3DFabrik/Rotor_Remote_V1_TFT/Pictures/CDE_controler_refurbish (1).JPG

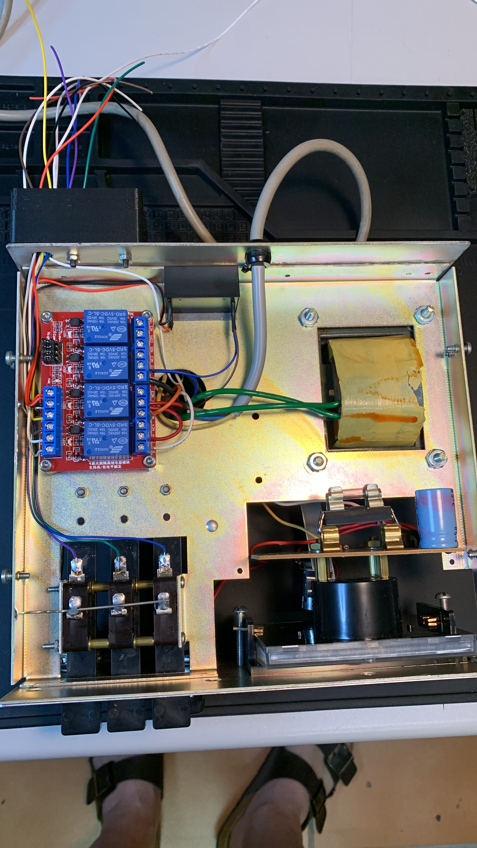
Pictures/CDE_controler_refurbish (1).JPG
