3DFabrik/Rotor_Remote_V1_TFT/Pictures/CDE_controler_refurbish (5).JPG

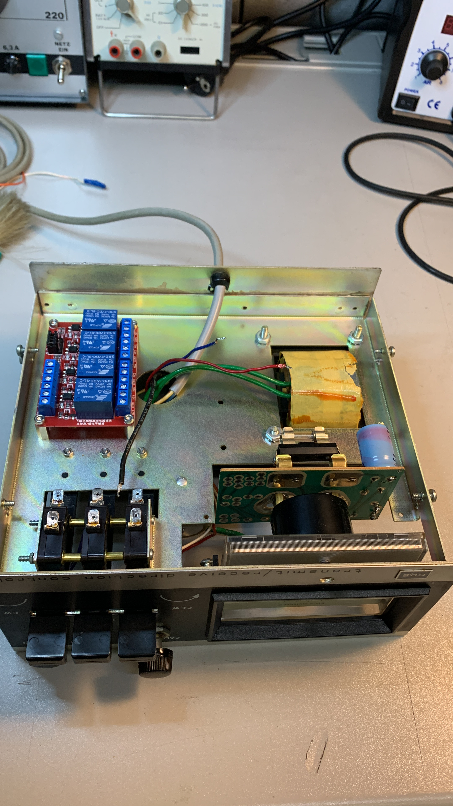
Pictures/CDE_controler_refurbish (5).JPG
