3DFabrik/Rotor_Remote_V1_TFT/Pictures/Innen 1.png

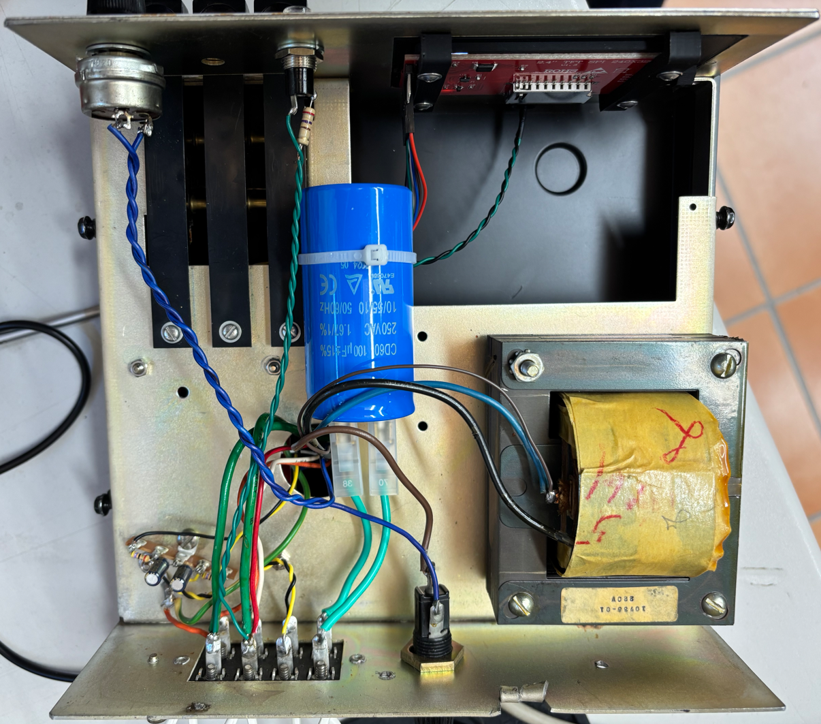
Pictures/Innen 1.png
