3DFabrik/Rotor_Remote_V1_TFT/Pictures/Pot supply filter (2).JPG

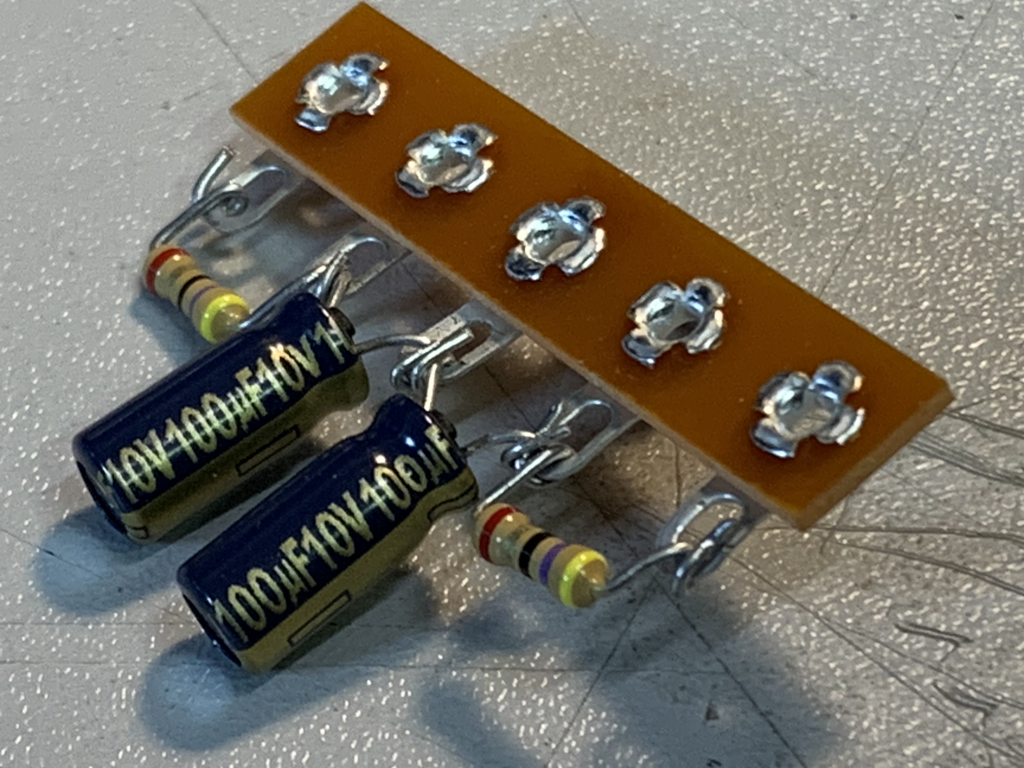
Pictures/Pot supply filter (2).JPG
