3DFabrik/Rotor_Remote_V1_TFT/Pictures/Pot supply filter (4).JPG

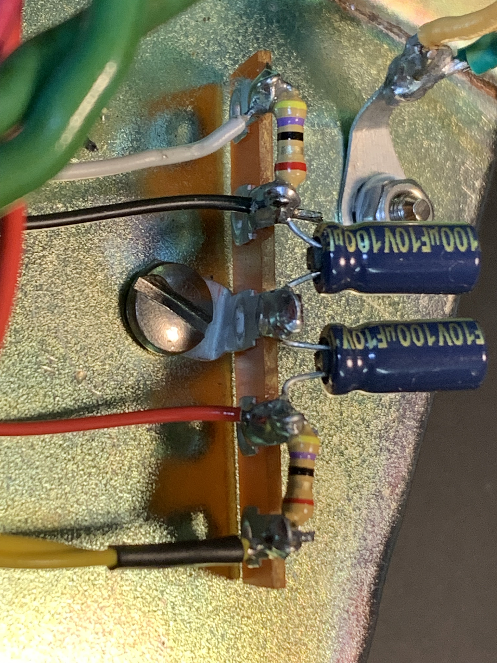
Pictures/Pot supply filter (4).JPG
