3DFabrik/Rotor_Remote_V1_TFT/RotorWifi.ino

WiFiServer rotServer;
WiFiClient rotClient;
bool rotServerStarted = false;
WebServer httpOta(80);
static bool otaReady = false;
static bool otaBusy = false;
static bool otaWeb = false;
static bool otaBeginOk = false;
static bool otaOk = false;
static bool otaUploadStarted = false;
unsigned long otaWifiLostAt = 0;
static String otaErr;
static void otaQuiesceNetwork();

static int wifiScanState = 0;  // 0 idle, 1 running, 2 done
static int wifiScanN = 0;
static bool wifiScanDirty = false;

static char rotLine[96];
static int rotLineLen = 0;

static const int WEB_LOG_N = 16;
static const int WEB_LOG_W = 96;
static char webLogLines[WEB_LOG_N][WEB_LOG_W];
static uint8_t webLogHead = 0;
static uint8_t webLogCount = 0;
static bool ntpStarted = false;

int webJog = 0;
unsigned long webJogAt = 0;
static uint32_t statusHits = 0;
static uint32_t jogHits = 0;

void webLog(const char *src, const char *msg) {
  if (!src) src = "";
  if (!msg) msg = "";
  char stamp[24] = "--";
  time_t now = time(nullptr);
  if (now > 1700000000) {
    struct tm tmNow;
    localtime_r(&now, &tmNow);
    strftime(stamp, sizeof(stamp), "%d.%m.%Y %H:%M:%S", &tmNow);
  }
  char *d = webLogLines[webLogHead];
  snprintf(d, WEB_LOG_W, "%s %s %s", stamp, src, msg);
  NETLOG("log %s", d);
  webLogHead = (webLogHead + 1) % WEB_LOG_N;
  if (webLogCount < WEB_LOG_N) webLogCount++;
}

static void webJogExpire() {
  if (webJog != 0 && (millis() - webJogAt > 500)) {
    webJog = 0;
    webLog("web", "stop");
  }
}

bool linkWantsBt() {
  return linkMode == LINK_BT;
}

bool linkWantsWifi() {
  return linkMode == LINK_WIFI;
}

const char *wifiStateLabel() {
  if (!wifiWanted && !linkWantsWifi()) return "off";
  switch (WiFi.status()) {
    case WL_CONNECTED: return "connected";
    case WL_NO_SSID_AVAIL: return "no SSID";
    case WL_CONNECT_FAILED: return "failed";
    case WL_CONNECTION_LOST: return "lost";
    case WL_DISCONNECTED: return "offline";
    default: return wifiSsid.length() ? "connecting..." : "no SSID";
  }
}

String wifiIpCurrent() {
  if (linkWantsWifi() && WiFi.status() == WL_CONNECTED) return WiFi.localIP().toString();
  return ipMode ? ipLocal : String("-");
}

int wifiRssiBars() {
  if (WiFi.status() != WL_CONNECTED) return 0;
  int r = WiFi.RSSI();
  if (r >= -55) return 3;
  if (r >= -70) return 2;
  if (r >= -85) return 1;
  return 0;
}

static void otaShowScreen(const char *msg, const char *sub = nullptr) {
  tft.fillScreen(TFT_BLACK);
  tft.setTextDatum(MC_DATUM);
  tft.setTextColor(TFT_YELLOW, TFT_BLACK);
  tft.drawString(msg, 160, 120, 4);
  if (sub) {
    tft.setTextColor(TFT_WHITE, TFT_BLACK);
    tft.drawString(sub, 160, 160, 2);
  }
  tft.setTextDatum(TL_DATUM);
}

static int otaPct = -1;

static void otaDrawProgress(unsigned long done, unsigned long total) {
  if (!total) return;
  int pct = (int)(done * 100UL / total);
  if (pct > 100) pct = 100;
  if (pct == otaPct) return;
  otaPct = pct;
  tft.drawRoundRect(40, 150, 240, 16, 3, TFT_WHITE);
  tft.fillRect(42, 152, (236 * pct) / 100, 12, TFT_GREEN);
  tft.setTextDatum(MC_DATUM);
  tft.setTextColor(TFT_WHITE, TFT_BLACK);
  tft.setTextPadding(80);
  tft.drawString(String(pct) + "%", 160, 190, 4);
  tft.setTextPadding(0);
  tft.setTextDatum(TL_DATUM);
}

static void otaGiveUp(const char *msg) {
  static bool once = false;
  if (once) return;
  once = true;
  Update.abort();
  otaShowScreen(msg);
  delay(1200);
  ESP.restart();
}

static void otaFailScreen(const String &err) {
  otaShowScreen("Update failed");
  tft.setTextDatum(MC_DATUM);
  tft.setTextColor(TFT_WHITE, TFT_BLACK);
  tft.drawString(err, 160, 170, 2);
  tft.setTextDatum(TL_DATUM);
}

bool otaIsBusy() {
  return otaBusy;
}

#define PAGE_CSS \
  "body{font-family:sans-serif;background:#111;color:#eee;margin:0}" \
  "header{background:#1a2332;padding:16px 20px;border-bottom:1px solid #345}" \
  "header h1{margin:0;font-size:22px;color:#6cf}" \
  ".ver{color:#9ab;margin-top:6px;font-size:14px}" \
  "nav{margin-top:14px}" \
  "nav a{color:#9ab;margin-right:18px;text-decoration:none}" \
  "nav a.on{color:#6cf;font-weight:bold}" \
  "main{padding:24px;max-width:640px}" \
  "p{line-height:1.45}" \
  ".note{color:#9ab}" \
  ".top{display:flex;gap:16px;align-items:center;flex-wrap:wrap;margin:12px 0}" \
  ".cards{display:flex;flex-direction:column;gap:12px;flex:1;min-width:150px}" \
  ".top svg{flex:none;width:200px;height:200px}" \
  ".card{background:#1a2332;border:1px solid #345;border-radius:8px;padding:14px}" \
  ".card h2{margin:0 0 8px;font-size:13px;color:#9ab;font-weight:normal}" \
  ".big{font-size:28px;color:#6cf}" \
  ".badge{display:inline-block;padding:2px 10px;border-radius:10px;background:#333;color:#9ab;font-size:12px}" \
  ".badge.on{background:#1a6;color:#fff}" \
  "select.log{width:100%;height:220px;background:#0d1117;color:#c9d1d9;border:1px solid #345;" \
  "font-family:ui-monospace,monospace;font-size:13px;padding:4px}" \
  ".jog{display:flex;gap:8px;align-items:center;flex-wrap:wrap;margin:8px 0 18px}" \
  ".jog button{font-size:15px;padding:10px 16px;background:#246;color:#fff;border:0;border-radius:8px;touch-action:none;" \
  "user-select:none;-webkit-user-select:none;-webkit-touch-callout:none;-webkit-tap-highlight-color:transparent}" \
  ".jog button:active{background:#3a7}" \
  ".jog input:not([type=checkbox]){width:84px;font-size:16px;padding:9px;background:#0d1117;color:#eee;border:1px solid #345;border-radius:6px}" \
  ".jog #tcall{width:150px;text-transform:uppercase}.jog label{color:#9ab;font-size:14px}" \
  ".tx{background:#0d1117;color:#eee;border:1px solid #345;border-radius:6px;padding:9px;font-size:16px}" \
  ".wide{width:100%;max-width:420px;box-sizing:border-box}" \
  ".btn{font-size:15px;padding:10px 16px;background:#246;color:#fff;border:0;border-radius:8px}" \
  ".jog #go{background:#2a7}.jog #stp{background:#a33}" \
  "input[type=file]{display:block;margin:16px 0}" \
  "input[type=submit]{font-size:16px;padding:10px 18px;background:#246;color:#fff;border:0;border-radius:6px}"

#define PAGE_HEAD(NAV) \
  "<!DOCTYPE html><html><head><meta charset='utf-8'>" \
  "<meta name='viewport' content='width=device-width,initial-scale=1'>" \
  "<title>RotorRemote</title><style>" PAGE_CSS "</style></head><body>" \
  "<header><h1>RotorRemote</h1><div class='ver'>Firmware <span id='ver'>-</span></div>" \
  "<nav>" NAV "</nav></header><main>"

// Served from flash so no heap is needed to build the page.
static const char HOME_PAGE[] PROGMEM =
  PAGE_HEAD("<a class='on' href='/'>Home</a><a href='/wavelog'>Wavelog</a><a href='/update'>Update</a>")
  "<p>rotctld: <span id='addr'>-</span> <span id='badge' class='badge'>no client</span></p>"
  "<div class='top'><div class='cards'>"
  "<div class='card'><h2>Azimuth</h2><div class='big' id='az'>-</div></div>"
  "<div class='card'><h2>Motion</h2><div class='big' id='dir'>-</div></div></div>"
  "<svg viewBox='0 0 200 200'>"
  "<circle cx='100' cy='100' r='84' fill='#0d1117' stroke='#345' stroke-width='2'/><g id='ticks'></g>"
  "<g fill='#6cf' font-size='14' text-anchor='middle'><text x='100' y='52'>N</text><text x='100' y='158'>S</text>"
  "<text x='166' y='106'>E</text><text x='34' y='106'>W</text></g>"
  "<g id='tg' visibility='hidden'><polygon points='100,15 93,2 107,2' fill='#fc3'/></g>"
  "<g id='ndl'><rect x='97' y='50' width='6' height='50' fill='#e33'/><polygon points='100,24 87,52 113,52' fill='#e33'/></g>"
  "<circle cx='100' cy='100' r='5' fill='#9ab'/></svg></div>"
  "<p class='note'>Target <span id='tgt'>-</span> &nbsp; Debug <span id='dbg'>-</span> &nbsp; Heap <span id='hp'>-</span></p>"
  "<div class='jog'><button id='ccw' type='button'>CCW</button><button id='cw' type='button'>CW</button>"
  "<input id='gaz' type='number' inputmode='numeric' min='0' max='359' placeholder='0-359'>"
  "<button id='go' type='button'>GO</button><button id='stp' type='button'>STOP</button>"
  "<span id='gmsg' class='note'></span></div>"
  "<div class='jog'><input id='tcall' type='text' autocapitalize='characters' autocomplete='off' spellcheck='false' placeholder='Call or locator'>"
  "<button id='fnd' type='button'>FIND</button><label><input id='lp' type='checkbox'> long path</label>"
  "<span id='tinfo' class='note'></span></div>"
  "<h2>rotctld / debug</h2>"
  "<select class='log' id='log' size='12'></select>"
  "<script>"
  "for(let i=0;i<36;i++){const l=document.createElementNS('http://www.w3.org/2000/svg','line');"
  "l.setAttribute('x1',100);l.setAttribute('y1',16);l.setAttribute('x2',100);l.setAttribute('y2',16+(i%9==0?14:i%3==0?9:5));"
  "l.setAttribute('stroke','#9ab');l.setAttribute('transform','rotate('+i*10+' 100 100)');ticks.appendChild(l);}"
  "async function tick(){try{const r=await fetch('/status',{cache:'no-store'});if(r.ok){const s=await r.json();"
  "az.textContent=Number(s.az).toFixed(1)+'\\u00b0';"
  "dir.textContent=s.dir;dir.style.color=s.turning?'#6f6':'#9ab';"
  "tgt.textContent=s.target+'\\u00b0';dbg.textContent=s.debug?'on':'off';"
  "badge.textContent=s.client?'client connected':'no client';badge.className=s.client?'badge on':'badge';"
  "ndl.setAttribute('transform','rotate('+s.az+' 100 100)');"
  "if(s.auto){tg.setAttribute('visibility','visible');tg.setAttribute('transform','rotate('+s.target+' 100 100)');}"
  "else tg.setAttribute('visibility','hidden');"
  "ver.textContent=s.ver;addr.textContent=s.ip+':'+s.port;hp.textContent=s.heap;"
  "const el=log;el.innerHTML='';"
  "(s.log||[]).forEach(t=>el.add(new Option(t)));"
  "if(el.options.length)el.selectedIndex=el.options.length-1;"
  "}}catch(e){}setTimeout(tick,800);}tick();"
  "function bindJog(id,dir){const el=document.getElementById(id);let on=false,t=null;"
  "const H={'Content-Type':'application/x-www-form-urlencoded'};"
  "const stop=()=>{if(!on)return;on=false;clearInterval(t);fetch('/jog',{method:'POST',headers:H,body:'dir=stop'}).catch(()=>{});};"
  "const send=b=>fetch('/jog',{method:'POST',headers:H,body:b}).then(r=>{if(r.status==409&&on){on=false;clearInterval(t);}}).catch(()=>{});"
  "el.addEventListener('pointerdown',e=>{e.preventDefault();if(on)return;el.setPointerCapture(e.pointerId);on=true;"
  "send('dir='+dir+'&start=1');t=setInterval(()=>send('dir='+dir),200);});"
  "['pointerup','pointercancel','lostpointercapture','touchend','touchcancel','contextmenu','selectstart'].forEach(n=>"
  "el.addEventListener(n,e=>{if(n=='contextmenu'||n=='selectstart')e.preventDefault();stop();}));"
  "window.addEventListener('blur',stop);window.addEventListener('pagehide',stop);"
  "document.addEventListener('visibilitychange',stop);}"
  "bindJog('ccw','ccw');bindJog('cw','cw');"
  "const hdr={'Content-Type':'application/x-www-form-urlencoded'};"
  "const say=m=>{gmsg.textContent=m;setTimeout(()=>{gmsg.textContent='';},2500);};"
  "const send2=b=>fetch('/go',{method:'POST',headers:hdr,body:b}).then(r=>say(r.ok?'ok':r.status==409?'busy':'rejected')).catch(()=>say('no answer'));"
  "go.onclick=()=>{const v=gaz.value.trim();if(!/^\\d{1,3}$/.test(v)||+v>359){say('0-359');gaz.focus();return;}send2('az='+v);};"
  "stp.onclick=()=>send2('stop=1');"
  "gaz.addEventListener('keydown',e=>{if(e.key=='Enter')go.click();});"
  "const LOC=/^[A-R]{2}\\d\\d([A-X]{2}(\\d\\d)?)?$/i;"
  "function l2ll(g){g=g.toUpperCase();let lon=(g.charCodeAt(0)-65)*20-180,lat=(g.charCodeAt(1)-65)*10-90,w=2,h=1;"
  "lon+=+g[2]*2;lat+=+g[3];"
  "if(g.length>=6){w=2/24;h=1/24;lon+=(g.charCodeAt(4)-65)*w;lat+=(g.charCodeAt(5)-65)*h;"
  "if(g.length==8){w/=10;h/=10;lon+=+g[6]*w;lat+=+g[7]*h;}}"
  "return[lat+h/2,lon+w/2];}"
  "function brg(a,b){const r=Math.PI/180,f1=a[0]*r,f2=b[0]*r,dl=(b[1]-a[1])*r;"
  "return(Math.atan2(Math.sin(dl)*Math.cos(f2),Math.cos(f1)*Math.sin(f2)-Math.sin(f1)*Math.cos(f2)*Math.cos(dl))/r+360)%360;}"
  "function dst(a,b){const r=Math.PI/180,dp=(b[0]-a[0])*r,dl=(b[1]-a[1])*r;"
  "const h=Math.sin(dp/2)**2+Math.cos(a[0]*r)*Math.cos(b[0]*r)*Math.sin(dl/2)**2;return 12742*Math.asin(Math.sqrt(h));}"
  "function wb(u){return u.replace(/\\/+$/,'').replace(/\\/api\\/v2$/,'').replace(/\\/index\\.php$/,'')+'/index.php/api/v2';}"
  "async function wl(S,path){const r=await fetch(wb(S.url)+'/'+path,{headers:{'Authorization':'Bearer '+S.key}});"
  "if(!r.ok){let m='Wavelog answered '+r.status;try{const e=await r.json();if(e.error)m=e.error.message||e.error.code;}catch(_){}throw new Error(m);}"
  "return(await r.json()).data;}"
  "fnd.onclick=async()=>{try{tinfo.textContent='...';"
  "const S=await(await fetch('/wl.json',{cache:'no-store'})).json();"
  "const q=tcall.value.trim().toUpperCase();if(!q)throw new Error('Enter a call or locator');"
  "let ll,lab=q,approx=false;"
  "if(LOC.test(q)){ll=l2ll(q);}else{"
  "if(!S.url||!S.key)throw new Error('Set URL and token on the Wavelog tab');"
  "const j=await wl(S,'lookup?callsign='+encodeURIComponent(q)+'&detail=full&callbook=true');"
  "const cb=j.callbook||{};const g=[j.gridsquare,cb.gridsquare,cb.grid,cb.locator].find(x=>x&&LOC.test(x));"
  "if(g){ll=l2ll(g);lab=q+' '+g;}"
  "else if(isFinite(parseFloat(j.dxcc_lat))&&isFinite(parseFloat(j.dxcc_long))){ll=[+j.dxcc_lat,+j.dxcc_long];approx=true;}"
  "else throw new Error('No location for '+q);}"
  "let me=S.loc;if(!me){if(!S.url||!S.key)throw new Error('Own locator missing');"
  "const st=await wl(S,'station');const a=st.find(x=>x.active)||st[0];me=a&&a.gridsquare;}"
  "if(!me||!LOC.test(me))throw new Error('Own locator unknown');"
  "const own=l2ll(me);let b=brg(own,ll),d=dst(own,ll);"
  "if(lp.checked){b=(b+180)%360;d=40030-d;}"
  "const az=Math.round(b)%360;gaz.value=az;"
  "tinfo.textContent=lab+(approx?' (country centre)':'')+': '+az+'\\u00b0, '+Math.round(d)+' km'+(lp.checked?' long path':'')+'. Press GO.';"
  "}catch(e){tinfo.textContent=(e instanceof TypeError)?'No answer from Wavelog (URL or CORS)':e.message;}};"
  "tcall.addEventListener('keydown',e=>{if(e.key=='Enter')fnd.click();});"
  "</script></main></body></html>";

static const char UPDATE_PAGE[] PROGMEM =
  PAGE_HEAD("<a href='/'>Home</a><a href='/wavelog'>Wavelog</a><a class='on' href='/update'>Update</a>")
  "<h2>Firmware update</h2>"
  "<p>Use <strong>RotorRemote_ota.bin</strong> (app image). Do not upload the USB merged <strong>RotorRemote.bin</strong>.</p>"
  "<form method='POST' action='/update' enctype='multipart/form-data'>"
  "<input type='file' name='firmware' accept='.bin'>"
  "<input type='submit' value='Flash'></form>"
  "<p class='note'>Leave the home page before flashing: it polls the controller. "
  "The display switches to Updating when the file transfer starts. "
  "The controller restarts after a successful update.</p>"
  "<script>fetch('/status').then(r=>r.json()).then(s=>{document.getElementById('ver').textContent=s.ver}).catch(()=>{});</script>"
  "</main></body></html>";

static const char WAVELOG_PAGE[] PROGMEM =
  PAGE_HEAD("<a href='/'>Home</a><a class='on' href='/wavelog'>Wavelog</a><a href='/update'>Update</a>")
  "<h2>Wavelog</h2>"
  "<p class='note'>Used on the Home page to find a callsign and turn the rotor towards it. "
  "In Wavelog create an <strong>API v2 token</strong> (user menu, API) with the scopes <strong>lookup:read</strong> and "
  "<strong>station:read</strong>. The token is stored in this controller and is visible to anyone who can open this page.</p>"
  "<p>URL<br><input id='wu' class='tx wide' type='text' placeholder='https://log.example.com' autocomplete='off'></p>"
  "<p>API v2 token (wl2_...)<br><input id='wk' class='tx wide' type='password' autocomplete='off'></p>"
  "<p>Own locator (empty = taken from the active Wavelog station)<br>"
  "<input id='wloc' class='tx' type='text' maxlength='8' placeholder='JO30oo' autocomplete='off'></p>"
  "<p><button id='sv' class='btn' type='button'>Save</button> <button id='ts' class='btn' type='button'>Test</button> "
  "<span id='wm' class='note'></span></p>"
  "<script>"
  "fetch('/status').then(r=>r.json()).then(s=>{ver.textContent=s.ver}).catch(()=>{});"
  "fetch('/wl.json',{cache:'no-store'}).then(r=>r.json()).then(s=>{wu.value=s.url;wk.value=s.key;wloc.value=s.loc;}).catch(()=>{});"
  "sv.onclick=async()=>{try{const b='url='+encodeURIComponent(wu.value.trim())+'&key='+encodeURIComponent(wk.value.trim())"
  "+'&loc='+encodeURIComponent(wloc.value.trim());"
  "const r=await fetch('/wl',{method:'POST',headers:{'Content-Type':'application/x-www-form-urlencoded'},body:b});"
  "wm.textContent=r.ok?'saved':'rejected: check the characters in URL, key and locator';}catch(e){wm.textContent='no answer';}};"
  "function wb(u){return u.replace(/\\/+$/,'').replace(/\\/api\\/v2$/,'').replace(/\\/index\\.php$/,'')+'/index.php/api/v2';}"
  "async function wl(S,path){const r=await fetch(wb(S.url)+'/'+path,{headers:{'Authorization':'Bearer '+S.key}});"
  "if(!r.ok){let m='Wavelog answered '+r.status;try{const e=await r.json();if(e.error)m=e.error.message||e.error.code;}catch(_){}throw new Error(m);}"
  "return(await r.json()).data;}"
  "ts.onclick=async()=>{try{wm.textContent='...';const S={url:wu.value.trim(),key:wk.value.trim()},out=[];"
  "await wl(S,'token');out.push('token ok');"
  "try{const st=await wl(S,'station');const a=st.find(x=>x.active)||st[0];out.push('station '+(a?a.gridsquare:'none'));}"
  "catch(e){out.push('station: '+e.message);}"
  "try{await wl(S,'lookup?callsign=DL1ABC&detail=basic');out.push('lookup ok');}catch(e){out.push('lookup: '+e.message);}"
  "wm.textContent=out.join(', ');}"
  "catch(e){wm.textContent='failed: '+e.message+(e instanceof TypeError?' (URL or network)':'');}};"
  "</script></main></body></html>";

static char statusJson[3072];

static bool wlPlain(const String &s, size_t maxLen, const char *extra) {
  if (s.length() > maxLen) return false;
  for (size_t i = 0; i < s.length(); i++) {
    char c = s.charAt(i);
    if (!isalnum((unsigned char)c) && !strchr(extra, c)) return false;
  }
  return true;
}

static size_t statusAdd(size_t n, const char *s) {
  while (*s && n + 1 < sizeof(statusJson)) statusJson[n++] = *s++;
  statusJson[n] = 0;
  return n;
}

static size_t statusAddEsc(size_t n, const char *s) {
  while (*s && n + 2 < sizeof(statusJson)) {
    unsigned char c = (unsigned char)*s++;
    if (c < 32) continue;
    if (c == '"' || c == '\\') statusJson[n++] = '\\';
    statusJson[n++] = (char)c;
  }
  statusJson[n] = 0;
  return n;
}

static size_t buildStatusJson() {
  const char *dir = "Stopped";
  bool ccw = digitalRead(pin_out_CCW_relais);
  bool cw = digitalRead(pin_out_CW_relais);
  if (ccw) dir = "Turning CCW";
  else if (cw) dir = "Turning CW";
  int compassTarget = azimut_tar + 180;
  if (compassTarget >= 360) compassTarget -= 360;
  char num[16];
  size_t n = 0;
  statusJson[0] = 0;
  n = statusAdd(n, "{\"az\":");
  snprintf(num, sizeof(num), "%.1f", (double)azimut);
  n = statusAdd(n, num);
  n = statusAdd(n, ",\"target\":");
  snprintf(num, sizeof(num), "%d", compassTarget);
  n = statusAdd(n, num);
  n = statusAdd(n, ",\"turning\":");
  n = statusAdd(n, (ccw || cw) ? "true" : "false");
  n = statusAdd(n, ",\"auto\":");
  n = statusAdd(n, b_autorotate ? "true" : "false");
  n = statusAdd(n, ",\"speed\":");
  snprintf(num, sizeof(num), "%.1f", (double)v_turn);
  n = statusAdd(n, num);
  n = statusAdd(n, ",\"dir\":\"");
  n = statusAdd(n, dir);
  n = statusAdd(n, "\",\"debug\":");
  n = statusAdd(n, debug ? "true" : "false");
  n = statusAdd(n, ",\"client\":");
  n = statusAdd(n, (rotClient && rotClient.connected()) ? "true" : "false");
  n = statusAdd(n, ",\"heap\":");
  snprintf(num, sizeof(num), "%u", (unsigned)ESP.getFreeHeap());
  n = statusAdd(n, num);
  n = statusAdd(n, ",\"maxblk\":");
  snprintf(num, sizeof(num), "%u", (unsigned)ESP.getMaxAllocHeap());
  n = statusAdd(n, num);
  n = statusAdd(n, ",\"ver\":\"" FW_VERSION "\",\"ip\":\"");
  n = statusAdd(n, WiFi.localIP().toString().c_str());
  n = statusAdd(n, "\",\"port\":");
  snprintf(num, sizeof(num), "%d", rotPort);
  n = statusAdd(n, num);
  n = statusAdd(n, ",\"log\":[");
  int start = (webLogHead + WEB_LOG_N - webLogCount) % WEB_LOG_N;
  for (int i = 0; i < webLogCount; i++) {
    if (i) n = statusAdd(n, ",");
    n = statusAdd(n, "\"");
    n = statusAddEsc(n, webLogLines[(start + i) % WEB_LOG_N]);
    n = statusAdd(n, "\"");
  }
  n = statusAdd(n, "]}");
  return n;
}

static void otaStop() {
  if (!otaReady) return;
  httpOta.stop();
  ArduinoOTA.end();
  otaReady = false;
}

static void otaBegin() {
  if (otaReady) return;

  ArduinoOTA.setHostname(btName.length() ? btName.c_str() : "RotorRemote");
  ArduinoOTA.onStart([]() {
    otaQuiesceNetwork();
    otaPct = -1;
    otaShowScreen("Updating...");
  });
  ArduinoOTA.onProgress([](unsigned int done, unsigned int total) {
    otaDrawProgress(done, total);
  });
  ArduinoOTA.onEnd([]() {
    otaShowScreen("Update OK", "Restarting...");
  });
  ArduinoOTA.onError([](ota_error_t err) {
    (void)err;
    otaGiveUp("Update failed");
  });
  ArduinoOTA.begin();

  httpOta.on("/", HTTP_GET, []() {
    NETLOG("http / from %s", httpOta.client().remoteIP().toString().c_str());
    httpOta.send_P(200, "text/html", HOME_PAGE);
  });

  httpOta.on("/status", HTTP_GET, []() {
    statusHits++;
    if (otaBusy) {
      httpOta.send(503, "text/plain", "busy");
      return;
    }
    buildStatusJson();
    httpOta.send(200, "application/json", statusJson);
  });

  httpOta.on("/jog", HTTP_POST, []() {
    jogHits++;
    String dir = httpOta.arg("dir");
    int cmd = 0;
    if (dir == "ccw") cmd = 1;
    else if (dir == "cw") cmd = 2;
    if (cmd == 0) {  // stop is always accepted, from any client
      if (webJog) webLog("web", "stop");
      webJog = 0;
      httpOta.send(200, "text/plain", "ok");
      return;
    }
    if (otaBusy || menuOpen || b_autorotate || but_BRK) {
      if (webJog) {
        webJog = 0;
        webLog("web", "stop");
      }
      httpOta.send(409, "text/plain", "busy");
      return;
    }
    if (httpOta.hasArg("start")) {  // only a fresh press may start; an opposite press while moving stops instead
      if (webJog != 0 && webJog != cmd) {
        webJog = 0;
        webLog("web", "stop (conflict)");
        httpOta.send(409, "text/plain", "busy");
        return;
      }
      if (webJog != cmd) webLog("web", cmd == 1 ? "CCW" : "CW");
      webJog = cmd;
      webJogAt = millis();
    } else if (webJog == cmd) {  // a heartbeat only keeps a running jog alive
      webJogAt = millis();
    } else {
      httpOta.send(409, "text/plain", "stopped");
      return;
    }
    httpOta.send(200, "text/plain", "ok");
  });

  httpOta.on("/go", HTTP_POST, []() {
    if (httpOta.hasArg("stop")) {  // stop is always accepted
      webJog = 0;
      if (b_autorotate) webLog("web", "stop");
      stopAutorotate();
      httpOta.send(200, "text/plain", "ok");
      return;
    }
    String a = httpOta.arg("az");
    bool digits = a.length() > 0 && a.length() <= 3;
    for (unsigned i = 0; digits && i < a.length(); i++) digits = isDigit(a.charAt(i));
    int v = digits ? a.toInt() : -1;
    if (v < 0 || v > 359) {
      httpOta.send(400, "text/plain", "angle 0-359");
      return;
    }
    if (otaBusy || menuOpen || b_autorotate || but_BRK || calIsActive() || webJog) {
      httpOta.send(409, "text/plain", "busy");
      return;
    }
    applyAzimuthTarget(v);
    webLog("web", (String("goto ") + v).c_str());
    httpOta.send(200, "text/plain", "ok");
  });

  httpOta.on("/wavelog", HTTP_GET, []() {
    httpOta.send_P(200, "text/html", WAVELOG_PAGE);
  });

  httpOta.on("/wl.json", HTTP_GET, []() {
    String j = "{\"url\":\"" + preferences.getString("wl_url", "") + "\",\"key\":\"" + preferences.getString("wl_key", "") +
               "\",\"loc\":\"" + preferences.getString("wl_loc", "") + "\"}";
    httpOta.sendHeader("Cache-Control", "no-store");
    httpOta.send(200, "application/json", j);
  });

  httpOta.on("/wl", HTTP_POST, []() {  // only plain characters are accepted, so the values can go into JSON unescaped
    String url = httpOta.arg("url"), key = httpOta.arg("key"), loc = httpOta.arg("loc");
    bool ok = wlPlain(url, 120, ":/._~%-?=&#+") && wlPlain(key, 80, "-_.") && wlPlain(loc, 8, "") &&
              (url.length() == 0 || url.startsWith("http://") || url.startsWith("https://")) &&
              (loc.length() == 0 || loc.length() == 4 || loc.length() == 6 || loc.length() == 8);
    if (!ok) {
      httpOta.send(400, "text/plain", "rejected");
      return;
    }
    preferences.putString("wl_url", url);
    preferences.putString("wl_key", key);
    preferences.putString("wl_loc", loc);
    webLog("web", "wavelog settings saved");
    httpOta.send(200, "text/plain", "ok");
  });

  httpOta.on("/update", HTTP_GET, []() {
    httpOta.send_P(200, "text/html", UPDATE_PAGE);
  });

  httpOta.on("/update", HTTP_POST, []() {
    httpOta.sendHeader("Connection", "close");
    if (otaOk) {
      otaShowScreen("Update OK", "Restarting...");
      httpOta.send(200, "text/html",
        "<!DOCTYPE html><html><head><meta charset='utf-8'><title>Restarting</title>"
        "<style>body{font-family:sans-serif;background:#111;color:#eee;padding:24px}h1{color:#6cf}</style>"
        "</head><body><h1>Restarting</h1><p>The new firmware will be ready in a moment.</p>"
        "<script>async function back(){try{const r=await fetch('/',{cache:'no-store'});"
        "if(r.ok){location.replace('/');return;}}catch(e){}setTimeout(back,1000);}"
        "setTimeout(back,2000);</script></body></html>");
      delay(800);
      ESP.restart();
    } else {
      if (!otaErr.length() || otaErr == "No Error") otaErr = "aborted";
      Update.abort();
      otaFailScreen(otaErr);
      httpOta.send(500, "text/plain", otaErr);
      delay(2500);
      ESP.restart();
    }
  }, []() {
    HTTPUpload &upload = httpOta.upload();
    if (upload.status == UPLOAD_FILE_START) {
      otaUploadStarted = true;
      otaWeb = true;
      otaBusy = true;
      b_autorotate = false;
      rotCmd = 0;
      webJog = 0;
      digitalWrite(pin_out_CCW_relais, LOW);
      digitalWrite(pin_out_CW_relais, LOW);
      digitalWrite(pin_out_BRK_relais, LOW);
      rotctlStopServer();
      rotLineLen = 0;
      spr.deleteSprite();
      spr_angle.deleteSprite();
      otaShowScreen("Updating...");
      otaPct = -1;
      Update.abort();
      WiFi.setSleep(false);
      httpOta.client().setTimeout(60000);
      otaBeginOk = Update.begin(UPDATE_SIZE_UNKNOWN);
      if (!otaBeginOk) {
        otaErr = Update.getError() ? Update.errorString() : ("start failed " + String(ESP.getMaxAllocHeap()));
        Update.printError(Serial);
        Serial.println(otaErr);
      }
    } else if (upload.status == UPLOAD_FILE_WRITE) {
      if (otaBeginOk && !otaErr.length() && upload.currentSize) {
        if (Update.write(upload.buf, upload.currentSize) != upload.currentSize) {
          otaErr = Update.getError() ? Update.errorString() : "write failed";
          otaBeginOk = false;
          Update.printError(Serial);
          Serial.println(otaErr);
        }
        otaDrawProgress(upload.totalSize, httpOta.clientContentLength());
      }
      yield();
    } else if (upload.status == UPLOAD_FILE_END) {
      if (otaBeginOk && !otaErr.length()) {
        if (Update.end(true)) {
          otaOk = true;
        } else {
          otaErr = Update.getError() ? Update.errorString() : "finalize failed";
          otaErr += " ";
          otaErr += String((unsigned long)upload.totalSize);
          Update.printError(Serial);
          Serial.println(otaErr);
        }
      } else if (!otaErr.length()) {
        otaErr = "no image";
      }
    } else if (upload.status == UPLOAD_FILE_ABORTED) {
      if (!otaOk && !otaErr.length()) otaErr = "connection lost";
    }
  });

  httpOta.begin();
  otaReady = true;
  if (debug) Serial.println("OTA http://" + WiFi.localIP().toString() + "/update");
}

bool rotctlListening() {
  return rotServerStarted && !otaBusy;
}

bool rotctlClientConnected() {
  return rotServerStarted && rotClient && rotClient.connected();
}

void rotctlCloseClient() {
  if (rotClient) rotClient.stop();
}

void rotctlStopServer() {
  rotctlCloseClient();
  if (rotServerStarted) {
    rotServer.stop();
    rotServerStarted = false;
  }
}

static void otaQuiesceNetwork() {
  otaBusy = true;
  stopAutorotate();
  rotctlStopServer();
  rotLineLen = 0;
  if (serialBtOn) {
    SerialBT.end();
    serialBtOn = false;
  }
  webLog("ota", "rotctld dropped");
}

void wifiStop() {
  otaStop();
  rotctlStopServer();
  wifiWanted = false;
  WiFi.disconnect(true);
  WiFi.mode(WIFI_OFF);
}

bool wifiCaptureCurrentIp() {  // seeds the static fields with the live DHCP lease
  if (!linkWantsWifi() || WiFi.status() != WL_CONNECTED) return false;
  IPAddress dns = WiFi.dnsIP();
  if (dns == IPAddress((uint32_t)0)) dns = WiFi.gatewayIP();
  ipLocal = WiFi.localIP().toString();
  ipGw = WiFi.gatewayIP().toString();
  ipMask = WiFi.subnetMask().toString();
  ipDns = dns.toString();
  preferences.putString("ip_local", ipLocal);
  preferences.putString("ip_gw", ipGw);
  preferences.putString("ip_mask", ipMask);
  preferences.putString("ip_dns", ipDns);
  return true;
}

void wifiRestart() {
  otaStop();
  rotctlStopServer();
  wifiWanted = true;
  WiFi.disconnect(true);
  delay(50);
  WiFi.mode(WIFI_STA);
  if (ipMode == 1) {
    IPAddress a, g, m, d;
    if (!a.fromString(ipLocal)) a = IPAddress(192, 168, 1, 50);
    if (!g.fromString(ipGw)) g = IPAddress(192, 168, 1, 1);
    if (!m.fromString(ipMask)) m = IPAddress(255, 255, 255, 0);
    if (!d.fromString(ipDns)) d = IPAddress(192, 168, 1, 1);
    WiFi.config(a, g, m, d);
  } else {
    WiFi.config(IPAddress((uint32_t)0), IPAddress((uint32_t)0), IPAddress((uint32_t)0));
  }
  if (wifiSsid.length() > 0) {
    WiFi.begin(wifiSsid.c_str(), wifiPass.c_str());
  }
}

void restartBluetooth() {
  if (serialBtOn) {
    SerialBT.end();
    serialBtOn = false;
  }
  if (linkWantsBt()) {
    SerialBT.begin(btName);
    serialBtOn = true;
  }
}

void applyLinkMode() {
  if (linkWantsWifi()) {
    wifiRestart();
    return;
  }
  wifiWanted = false;
  if (!serialBtOn) {
    SerialBT.begin(btName);
    serialBtOn = true;
  }
}

int linkEffectiveMode() {
  return linkPendingMode >= 0 ? linkPendingMode : linkMode;
}

void linkTogglePending() {
  int target = linkEffectiveMode() == LINK_WIFI ? LINK_BT : LINK_WIFI;
  linkPendingMode = (target == linkMode) ? -1 : target;
}

void linkApplyPending() {
  int mode = linkPendingMode;
  linkPendingMode = -1;
  if (mode >= 0 && mode != linkMode) switchLinkAndRestart(mode);
}

// The Bluetooth stack cannot be freed at runtime, so the radio choice takes effect after a restart.
void switchLinkAndRestart(int mode) {
  preferences.putInt("link_mode", mode);
  tft.fillScreen(TFT_BLACK);
  tft.setTextDatum(MC_DATUM);
  tft.setTextColor(TFT_WHITE, TFT_BLACK);
  tft.drawString("Restarting...", 160, 120, 4);
  delay(200);
  ESP.restart();
}

void wifiConnectNow() {
  preferences.putString("wifi_ssid", wifiSsid);
  preferences.putString("wifi_pass", wifiPass);
  preferences.putInt("ip_mode", ipMode);
  preferences.putString("ip_local", ipLocal);
  preferences.putString("ip_gw", ipGw);
  preferences.putString("ip_mask", ipMask);
  preferences.putString("ip_dns", ipDns);
  preferences.putInt("rot_port", rotPort);
  if (!linkWantsWifi()) {
    linkPendingMode = LINK_WIFI;
    return;
  }
  wifiRestart();
}

void wifiStartScan() {
  WiFi.mode(WIFI_STA);
  WiFi.scanDelete();
  WiFi.scanNetworks(true, true);
  wifiScanState = 1;
  wifiScanN = 0;
  wifiScanDirty = false;
}

void wifiPollScan() {
  if (wifiScanState != 1) return;
  int n = WiFi.scanComplete();
  if (n == WIFI_SCAN_RUNNING) return;
  if (n < 0) {
    wifiScanN = 0;
  } else {
    wifiScanN = n;
  }
  wifiScanState = 2;
  wifiScanDirty = true;
}

void wifiScanStop() {
  WiFi.scanDelete();
  wifiScanState = 0;
  wifiScanN = 0;
  wifiScanDirty = false;
  if (!wifiWanted && !linkWantsWifi()) {
    WiFi.mode(WIFI_OFF);
  }
}

bool wifiScanRunning() {
  return wifiScanState == 1;
}

bool wifiTakeScanDirty() {
  if (!wifiScanDirty) return false;
  wifiScanDirty = false;
  return true;
}

int wifiScanCount() {
  return wifiScanN;
}

String wifiScanSSID(int i) {
  if (i < 0 || i >= wifiScanN) return "";
  return WiFi.SSID(i);
}

int wifiScanRSSI(int i) {
  if (i < 0 || i >= wifiScanN) return 0;
  return WiFi.RSSI(i);
}

static void netSlow(const char *what, unsigned long t0) {
  unsigned long dt = millis() - t0;
  if (dt >= 30) NETLOG("slow %s %lums", what, dt);
}

static void netStats() {
  if (!debug) return;
  static unsigned long last = 0, lastStat = 0, maxGap = 0;
  static int lastSt = -1;
  unsigned long now = millis();
  if (last && now - last > maxGap) maxGap = now - last;
  last = now;
  int st = linkWantsWifi() ? (int)WiFi.status() : -1;
  if (st != lastSt) {
    NETLOG("wifi status %d -> %d", lastSt, st);
    lastSt = st;
  }
  if (now - lastStat >= 5000) {
    lastStat = now;
    NETLOG("stat heap=%u maxblk=%u gapmax=%lums rotClient=%d web status=%u jog=%u",
           (unsigned)ESP.getFreeHeap(), (unsigned)ESP.getMaxAllocHeap(), maxGap,
           (rotClient && rotClient.connected()) ? 1 : 0, (unsigned)statusHits, (unsigned)jogHits);
    maxGap = 0;
  }
}

static void rotSend(const char *buf, size_t len) {
  unsigned long t0 = millis();
  size_t n = rotClient.write((const uint8_t *)buf, len);
  NETLOG("tx %u/%u bytes %lums", (unsigned)n, (unsigned)len, (unsigned long)(millis() - t0));
}

static void rotReply(const char *s) {
  char out[48];
  int len = snprintf(out, sizeof(out), "%s\n", s);
  rotSend(out, (size_t)len);
}

void rotctlSendPos(bool ext) {
  char buf[40];
  int len = snprintf(buf, sizeof(buf), "%.1f\n0.0\n%s", azimut, ext ? "RPRT 0\n" : "");
  rotSend(buf, (size_t)len);
}

// Hamlib rotctld \dump_state layout; clients read up to "done".
static const char ROT_DUMP_STATE[] =
  "1\n1\nmin_az=0.000000\nmax_az=360.000000\nmin_el=0.000000\nmax_el=180.000000\n"
  "south_zero=0\nrot_type=Az\ndone\n";

void rotctlHandle(char *line) {
  while (*line == ' ' || *line == '\t') line++;
  if (*line == 0) return;

  bool ext = false;
  if (*line == '+') {
    ext = true;
    line++;
  }
  if (*line == '\\') line++;
  while (*line == ' ' || *line == '\t') line++;
  if (*line == 0) return;

  if (line[0] == 'p' && (line[1] == 0 || isspace((unsigned char)line[1]))) {
    rotctlSendPos(ext);
    return;
  }
  if (!strncmp(line, "get_pos", 7) && (line[7] == 0 || isspace((unsigned char)line[7]))) {
    rotctlSendPos(ext);
    return;
  }

  if (line[0] == 'P' && (line[1] == 0 || isspace((unsigned char)line[1]))) {
    float az = 0, el = 0;
    sscanf(line + 1, "%f %f", &az, &el);
    applyAzimuthTarget((int)(az + 0.5f));
    rotReply("RPRT 0");
    return;
  }
  if (!strncmp(line, "set_pos", 7)) {
    float az = 0, el = 0;
    sscanf(line + 7, "%f %f", &az, &el);
    applyAzimuthTarget((int)(az + 0.5f));
    rotReply("RPRT 0");
    return;
  }

  if ((line[0] == 'S' && (line[1] == 0 || isspace((unsigned char)line[1]))) ||
      (!strncmp(line, "stop", 4) && (line[4] == 0 || isspace((unsigned char)line[4])))) {
    stopAutorotate();
    rotReply("RPRT 0");
    return;
  }

  if (line[0] == 'q' || !strncmp(line, "quit", 4)) {
    rotClient.stop();
    return;
  }

  if (!strncmp(line, "dump_state", 10)) {
    rotSend(ROT_DUMP_STATE, sizeof(ROT_DUMP_STATE) - 1);
    if (ext) rotReply("RPRT 0");
    return;
  }

  if (line[0] == '_' || !strncmp(line, "get_info", 8)) {
    rotReply("RotorRemote");
    if (ext) rotReply("RPRT 0");
    return;
  }

  rotReply("RPRT -11");
}

void rotctlRead() {
  int lines = 0;
  int backlog = rotClient.available();
  if (backlog > 48) NETLOG("rx backlog %d bytes", backlog);
  while (lines < 4 && rotClient.connected() && rotClient.available() > 0) {
    char c = (char)rotClient.read();
    if (c == '\r' || c == '\n') {
      if (rotLineLen > 0) {
        rotLine[rotLineLen] = '\0';
        NETLOG("rx '%s'", rotLine);
        static char lastLogged[sizeof(rotLine)];
        if (strcmp(lastLogged, rotLine) != 0) {
          webLog("rotctl", rotLine);
          strcpy(lastLogged, rotLine);
        }
        rotctlHandle(rotLine);
        rotLineLen = 0;
        lines++;
      }
      continue;
    }
    if (rotLineLen < (int)sizeof(rotLine) - 1) {
      rotLine[rotLineLen++] = c;
    }
  }
}

void rotctlService() {
  if (!rotServerStarted || otaBusy) return;
  if (rotServer.hasClient()) {
    WiFiClient incoming = rotServer.available();
    if (rotClient && rotClient.connected()) {
      rotClient.stop();
      webLog("rotctl", "client replaced");
    }
    rotClient = incoming;
    rotClient.setNoDelay(true);
    rotClient.setTimeout(1000);
    rotLineLen = 0;
    webLog("rotctl", "client connected");
    drawLinkStatus();
    if (debug) Serial.println("rotctld client connected");
  }
  static bool rotHadClient = false;
  if (rotClient && rotClient.connected()) {
    rotHadClient = true;
    rotctlRead();
  } else if (rotHadClient) {
    rotHadClient = false;
    webLog("rotctl", "client gone");
    rotClient.stop();
    drawLinkStatus();
  }
}

void wifiService() {
  netStats();
  wifiPollScan();
  webJogExpire();

  if (!wifiWanted) return;

  if (WiFi.status() == WL_CONNECTED) {
    if (!ntpStarted) {
      configTzTime("CET-1CEST,M3.5.0,M10.5.0/3", "pool.ntp.org");
      ntpStarted = true;
    }
    otaBegin();
    if (otaBusy) {
      if (!otaWeb) ArduinoOTA.handle();
      httpOta.handleClient();
      if (otaUploadStarted && !otaOk && otaErr.length()) {
        otaFailScreen(otaErr);
        delay(2000);
        ESP.restart();
      }
      return;
    }
    if (!rotServerStarted) {
      rotServer.begin(rotPort);
      rotServerStarted = true;
      rotLineLen = 0;
      webLog("wifi", "rotctld listening");
      drawLinkStatus();
      if (debug) Serial.println("rotctld listening on " + WiFi.localIP().toString() + ":" + String(rotPort));
    }
    unsigned long t0 = millis();
    rotctlService();
    netSlow("rotctlService", t0);
    t0 = millis();
    ArduinoOTA.handle();
    netSlow("ArduinoOTA", t0);
    t0 = millis();
    httpOta.handleClient();
    netSlow("handleClient", t0);
  } else if (!otaBusy && (rotServerStarted || otaReady)) {
    otaStop();
    rotctlStopServer();
  }
}
