3DFabrik/Rotor_Remote_V1_TFT/(commit log)

2026-10-06 Initial commit: ESP32 rotor remote with TFT setup menu and hamlib rotctld over WLAN.
2026-10-06 Calibrate on the noisy wirewound pot and keep link status as footer icons.
    Store the flashed ESP32 image in firmware/ so the current binary can be written without rebuilding.
2026-10-06 Switch the UI to English, show the firmware version, and enlarge the menu type.
2026-10-07 Keep normal driving off the stops and drop network clients during OTA.
    Smaller menu text, a tunable median, stand-only smoothing, calibration by speed stall, and an angle-error test.
    [RotorMenu.ino, RotorTypes.h, RotorWifi.ino, Rotor_Remote_V1_TFT_240903_1815.ino]
2026-10-07 Document the rotor remote, its functions, and the ESP pinout.
2026-10-07 Describe the isolated supply, relay board, and display, and add a wiring diagram.
2026-10-07 Show the wiring diagram as a PNG so it appears on GitHub.
2026-10-07 ci: build firmware and publish releases on demand
    Drop committed .bin artifacts; the workflow builds them with
    arduino-cli and attaches factory and OTA images to a GitHub
    release. Release version is injected as FW_VERSION at build
    time.
2026-10-07 ci: install arduino-cli via setup action
2026-10-07 ci: use latest arduino-cli, 1.2.1 does not exist
2026-10-07 ci: pin arduino-cli 1.5.1, latest resolution fails
2026-10-07 refactor: remove dead code, fix unknown-command check
    - fix assignment-in-if so unknown commands report again
    - drop unused bitmaps.h, globals and duplicate C handler
    - share one line reader for serial and bluetooth
    - answer help and stored values on bluetooth too, as documented
    [Rotor_Remote_V1_TFT.ino]
2026-10-07 Show live rotor status on the web page and start OTA only when the file is sent.
2026-10-08 Keep the status page and rotctld from stalling the same loop.
    Build /status in a fixed buffer, poll it without overlapping requests, service rotctld on its own, and stop allocating a String for every display digit. Rename the sketch so the filename matches the folder and Arduino CLI can build it.
    [RotorTypes.h, RotorWifi.ino, Rotor_Remote_V1_TFT_240903_1815.ino]
2026-10-08 Fix stalled web page and rotctld feedback; make Bluetooth and Wi-Fi exclusive.
    The heap was almost empty (13 KB): the Bluetooth controller memory stayed
    reserved and the home page was built as a String, so the 3 KB page never got
    sent and handleClient blocked the loop for seconds.
    - Serve the home and update pages from flash; version, IP and port come from /status.
    - rotctld: replies are LF-only single writes, a backslash no longer means
    extended response, dump_state uses the Hamlib layout ending in "done".
    - Bluetooth or Wi-Fi, never both. The choice is applied with a restart when the
    menu is left; Wi-Fi mode releases the Bluetooth controller memory; a crash
    in Bluetooth mode falls b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
    [RotorMenu.ino, RotorTypes.h, RotorWifi.ino, Rotor_Remote_V1_TFT_240903_1815.ino]
2026-10-08 Polish the display and web page; measure speed from real time.
    Display:
    - Menu status line no longer overwrites the hint line.
    - Main page: Angle, compass point and Speed laid out across the row,
    amber/red angle near the end stops, target marker on the scale,
    thin line above the footer, lighter grey for secondary text.
    - Footer shows the IP address when idle and "Goto <angle>" during
    automatic travel; alarms keep priority.
    - Small monitor icon next to the Wi-Fi icon shows a connected rotctld client.
    - Boot splash with version and link mode, OTA progress bar, scroll
    arrows in the menu.
    Web page:
    - Azimuth and Motion cards beside a compass dial with needle and target.
    - Badge for the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
    [RotorMenu.ino, RotorWifi.ino, Rotor_Remote_V1_TFT_240903_1815.ino]
2026-10-08 Make BRK an emergency stop and harden the web jog buttons.
    - BRK now stops the rotor whatever started it: buttons, web, rotctld,
    Bluetooth or automatic travel. Before, only automatic travel
    honoured it, so a web jog kept running.
    - In the calibration menu a BRK press stops a running drive and the
    release no longer triggers a select, so auto calibration cannot restart.
    - Web jog: only a fresh press may start a jog, the 200 ms heartbeats
    only keep a running jog alive, stop is accepted from any client and
    an opposite press while moving stops instead of reversing. A client
    whose release was lost can no longer restart the rotor after a stop.
    - Web page sends stop on release, cancel, l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
    [RotorMenu.ino, RotorWifi.ino, Rotor_Remote_V1_TFT_240903_1815.ino]
2026-10-08 Add menu help lines, web angle input and BRAKE ON/OFF; pre-fill static IP.
    - BRAKE box shows "BRAKE ON" in grey while the brake relay is not
    energised and "BRAKE OFF" in green while the rotor turns.
    - Menu pages show a grey help line for the selected row. Setup,
    Bluetooth and System have room for two lines; Wi-Fi (DHCP) and
    Calibration use one line. A running calibration shows its status in
    that line instead.
    Wi-Fi menu:
    - Switching from DHCP to static fills IP, gateway, mask and DNS from
    the current connection and stores them.
    - Compass needle is a single arrow.
    - Smaller CCW/CW buttons, an angle field (0-359) with GO and STOP.
    POST /go validates the angle a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
2026-10-08 Add a Wavelog tab and a callsign/locator finder to the web page.
    - New Wavelog tab stores the instance URL, an API v2 token and an
    optional own locator in the controller (preferences). Values are
    restricted to plain characters; the token is not logged.
    - Test checks token, station and lookup scopes and reports each result.
    - Home page: field for a callsign or Maidenhead locator with FIND and a
    long path option. The browser queries the Wavelog API v2 lookup
    (callbook, locator, DXCC centre as fallback), takes the own locator
    from the active station, computes the bearing and fills the angle
    field. The rotor only turns when GO is pressed.
    - README describes the tab and the finder.
2026-10-08 Rename the main sketch to match the repository name.
    The release workflow and arduino-cli expect Rotor_Remote_V1_TFT.ino, so the
    build could not find the old file name.
2026-10-08 Update the README: web interface, Wavelog lookup, emergency stop.
    - New Weboberfläche section: tabs, Home page, single-client driving rules
    and the HTTP paths.
    - New Wavelog section: API v2 token, setup, FIND and long path, where the
    location comes from, and security notes.
    - BRK emergency stop, corrected ADC timing, version display, rotctld note,
    and the sketch folder name needed to build.
