3DFabrik/Rotor_Remote_V1_TFT/Pictures/Pot supply filter (3).JPG

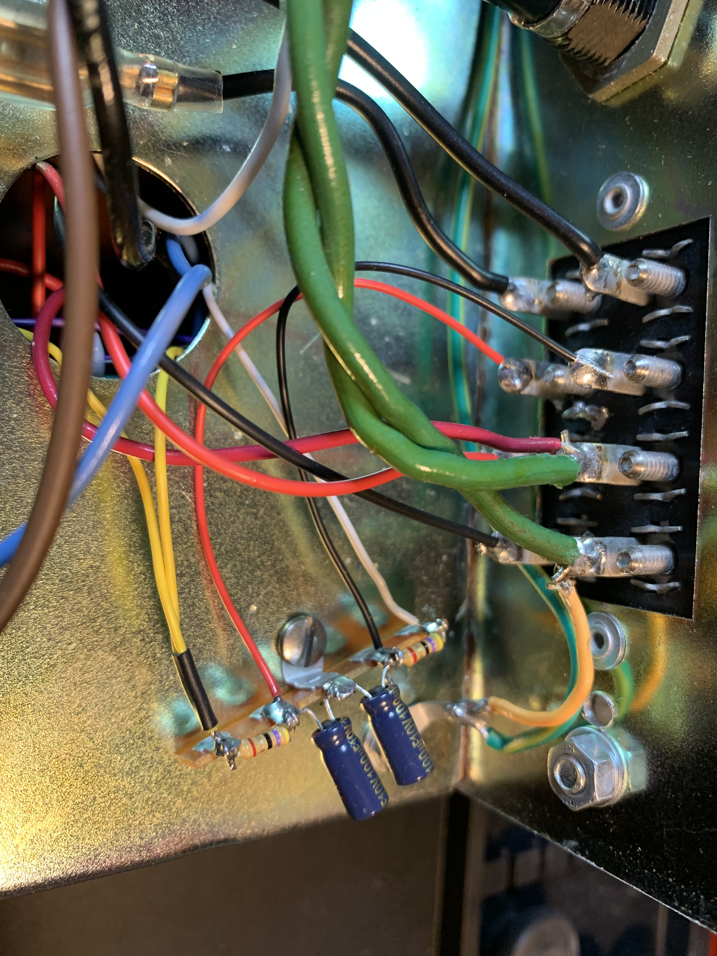
Pictures/Pot supply filter (3).JPG
